Fenytestver/WIP/pcb/SPCombined/schematics.brd

## EAGLE design pcb/SPCombined/schematics.brd (2019-07-12)

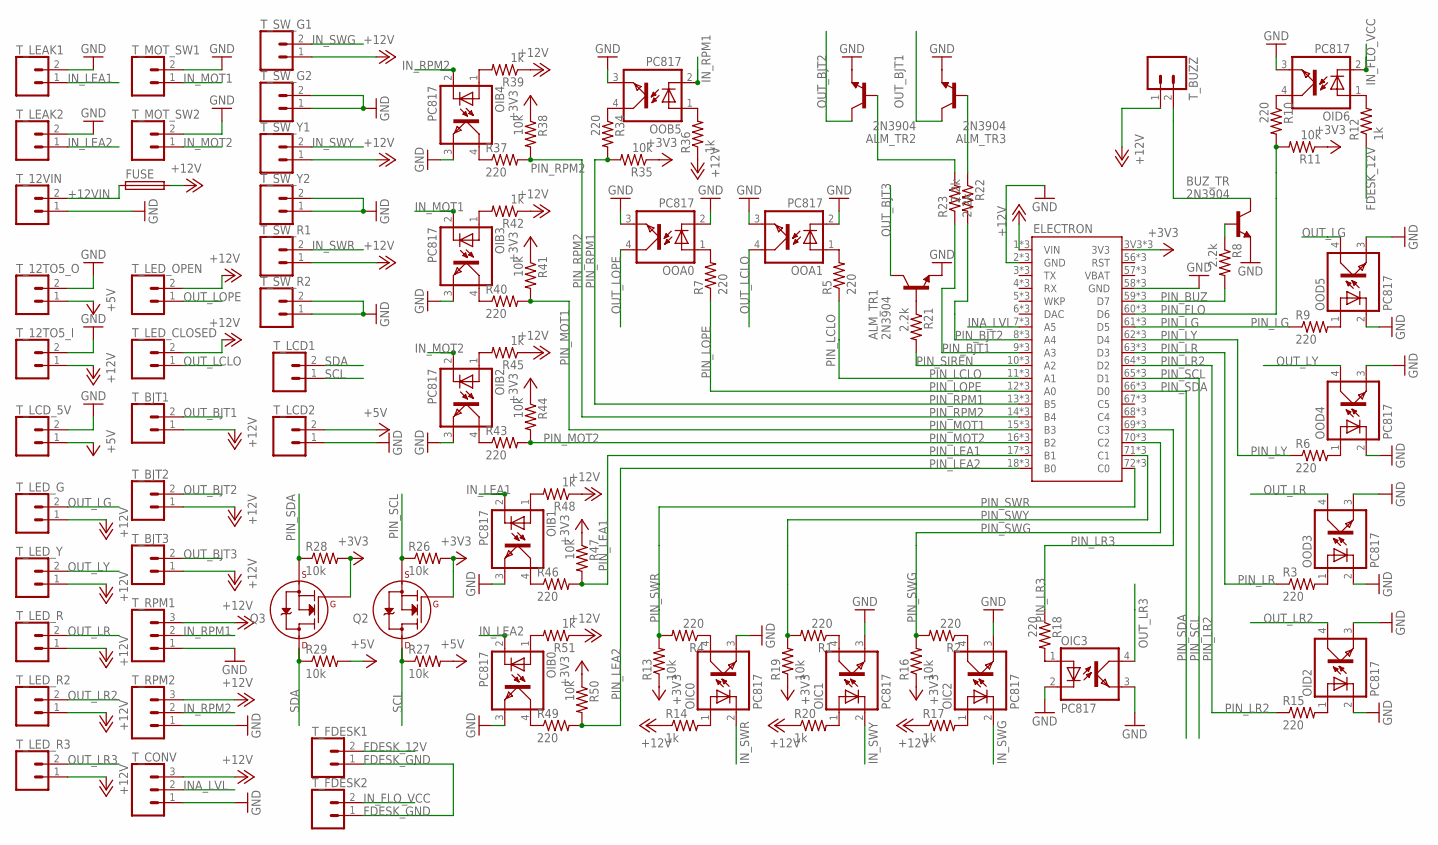
[picture p1: schematic schematics.sch]

Parts:
ALM_TR1, ALM_TR2, ALM_TR3: 2N3904; TO92
BUZ_TR: 2N3904; TO92
ELECTRON: ELECTRONDUALROW; ELECTRON_DUAL-ROW
FUSE: SH25
OIB0, OIB1, OIB2, OIB3, OIB4: PC817; DIL04
OIC0, OIC1, OIC2, OIC3: PC817; DIL04
OID2, OID6: PC817; DIL04
OOA0, OOA1: PC817; DIL04
OOB5: PC817; DIL04
OOD3, OOD4, OOD5: PC817; DIL04
Q2, Q3: 2N7000_TO92; TO-92
R1, R2, R3, R4, R5, R6, R7, R9, R10, R15, R18, R34, R37, R40, R43, R46, R49: 220; 0207/7
R8, R21, R22, R23: 2.2k; 0207/7
R11, R13, R16, R19, R26, R27, R28, R29, R35, R38, R41, R44, R47, R50: 10k; 0207/7
R12, R14, R17, R20, R36, R39, R42, R45, R48, R51: 1k; 0207/7
T_12TO5_I, T_12TO5_O, T_12VIN: CONN_025MM; SCREWTERMINAL-5MM-2
T_BJT1, T_BJT2, T_BJT3: CONN_025MM; SCREWTERMINAL-5MM-2
T_BUZZ: CONN_025MM; SCREWTERMINAL-5MM-2
T_CONV: CONN_03-SCREW-5MM; SCREWTERMINAL-5MM-3
T_FDESK1, T_FDESK2: CONN_025MM; SCREWTERMINAL-5MM-2
T_LCD1, T_LCD2: CONN_025MM; SCREWTERMINAL-5MM-2
T_LCD_5V: CONN_025MM; SCREWTERMINAL-5MM-2
T_LEAK1, T_LEAK2: CONN_025MM; SCREWTERMINAL-5MM-2
T_LED_CLOSED: CONN_025MM; SCREWTERMINAL-5MM-2
T_LED_G: CONN_025MM; SCREWTERMINAL-5MM-2
T_LED_OPEN: CONN_025MM; SCREWTERMINAL-5MM-2
T_LED_R, T_LED_R2, T_LED_R3: CONN_025MM; SCREWTERMINAL-5MM-2
T_LED_Y: CONN_025MM; SCREWTERMINAL-5MM-2
T_MOT_SW1, T_MOT_SW2: CONN_025MM; SCREWTERMINAL-5MM-2
T_RPM1, T_RPM2: CONN_03-SCREW-5MM; SCREWTERMINAL-5MM-3
T_SW_G1, T_SW_G2: CONN_025MM; SCREWTERMINAL-5MM-2
T_SW_R1, T_SW_R2: CONN_025MM; SCREWTERMINAL-5MM-2
T_SW_Y1, T_SW_Y2: CONN_025MM; SCREWTERMINAL-5MM-2

Connections:
+3V3: ELECTRON.3V3, ELECTRON.55 (3V3), ELECTRON.91 (3V3), Q2.2 (G), Q3.2 (G), R11.1, R13.1, R16.1, R19.1, R26.2, R28.2, R35.1, R38.1, R41.1, R44.1, R47.1, R50.1
+5V: R27.2, R29.2, T_12TO5_O.1, T_LCD2.2, T_LCD_5V.1
+12V: ELECTRON.1 (VIN), ELECTRON.37 (VIN), ELECTRON.VIN, FUSE.2, R14.1, R17.1, R20.1, R36.1, R39.1, R42.1, R45.1, R48.1, R51.1, T_12TO5_I.1, T_BJT1.1, T_BJT2.1, T_BJT3.1, T_BUZZ.1, T_CONV.3, T_LED_CLOSED.2, T_LED_G.1, T_LED_OPEN.2, T_LED_R.1, T_LED_R2.1, T_LED_R3.1, T_LED_Y.1, T_RPM1.3, T_RPM2.3, T_SW_G1.1, T_SW_R1.1, T_SW_Y1.1
+12VIN: FUSE.1, T_12VIN.2
FDESK_12V: R12.1, T_FDESK1.2
FDESK_GND: T_FDESK1.1, T_FDESK2.1
GND: ALM_TR1.3 (E), ALM_TR2.3 (E), ALM_TR3.3 (E), BUZ_TR.3 (E), ELECTRON.2 (GND), ELECTRON.38 (GND), ELECTRON.58 (GND), ELECTRON.94 (GND), ELECTRON.GND, ELECTRON.GND@2 (GND), OIB0.3 (EMIT), OIB1.3 (EMIT), OIB2.3 (EMIT), OIB3.3 (EMIT), OIB4.3 (EMIT), OIC0.3 (EMIT), OIC1.3 (EMIT), OIC2.3 (EMIT), OIC3.2 (C), OIC3.3 (EMIT), OID2.2 (C), OID2.3 (EMIT), OID6.3 (EMIT), OOA0.2 (C), OOA0.3 (EMIT), OOA1.2 (C), OOA1.3 (EMIT), OOB5.3 (EMIT), OOD3.2 (C), OOD3.3 (EMIT), OOD4.2 (C), OOD4.3 (EMIT), OOD5.2 (C), OOD5.3 (EMIT), T_12TO5_I.2, T_12TO5_O.2, T_12VIN.1, T_CONV.1, T_LCD2.1, T_LCD_5V.2, T_LEAK1.2, T_LEAK2.2, T_MOT_SW1.2, T_MOT_SW2.2, T_RPM1.1, T_RPM2.1, T_SW_G2.1, T_SW_G2.2, T_SW_R2.1, T_SW_R2.2, T_SW_Y2.1, T_SW_Y2.2
INA_LVL: ELECTRON.7 (A5), ELECTRON.43 (A5), ELECTRON.A5, T_CONV.2
IN_FLO_VCC: OID6.2 (C), T_FDESK2.2
IN_LEA1: OIB1.2 (C), T_LEAK1.1
IN_LEA2: OIB0.2 (C), T_LEAK2.1
IN_MOT1: OIB3.2 (C), T_MOT_SW1.1
IN_MOT2: OIB2.2 (C), T_MOT_SW2.1
IN_RPM1: OOB5.2 (C), T_RPM1.2
IN_RPM2: OIB4.2 (C), T_RPM2.2
IN_SWG: OIC2.2 (C), T_SW_G1.2
IN_SWR: OIC0.2 (C), T_SW_R1.2
IN_SWY: OIC1.2 (C), T_SW_Y1.2
unnamed: OOD3.1 (A), R3.2
unnamed: OIC1.1 (A), R20.2
unnamed: OOD4.1 (A), R6.2
unnamed: OIC2.1 (A), R17.2
unnamed: OOD5.1 (A), R9.2
unnamed: BUZ_TR.2 (B), R8.1
unnamed: BUZ_TR.1 (C), T_BUZZ.2
unnamed: OID2.1 (A), R15.2
unnamed: OIC0.1 (A), R14.2
unnamed: OID6.1 (A), R12.2
unnamed: OOA1.1 (A), R5.2
unnamed: OID6.4 (COL), R10.1
unnamed: OIC0.4 (COL), R4.1
unnamed: OIC3.1 (A), R18.2
unnamed: OOA0.1 (A), R7.2
unnamed: OIC2.4 (COL), R2.1
unnamed: OIC1.4 (COL), R1.1
unnamed: ALM_TR1.2 (B), R21.1
unnamed: ALM_TR3.2 (B), R22.1
unnamed: ALM_TR2.2 (B), R23.2
unnamed: OOB5.1 (A), R36.2
unnamed: OOB5.4 (COL), R34.1
unnamed: OIB4.1 (A), R39.2
unnamed: OIB4.4 (COL), R37.1
unnamed: OIB3.1 (A), R42.2
unnamed: OIB3.4 (COL), R40.1
unnamed: OIB2.1 (A), R45.2
unnamed: OIB2.4 (COL), R43.1
unnamed: OIB1.1 (A), R48.2
unnamed: OIB1.4 (COL), R46.1
unnamed: OIB0.1 (A), R51.2
unnamed: OIB0.4 (COL), R49.1
OUT_BJT1: ALM_TR3.1 (C), T_BJT1.2
OUT_BJT2: ALM_TR2.1 (C), T_BJT2.2
OUT_BJT3: ALM_TR1.1 (C), T_BJT3.2
OUT_LCLO: OOA1.4 (COL), T_LED_CLOSED.1
OUT_LG: OOD5.4 (COL), T_LED_G.2
OUT_LOPE: OOA0.4 (COL), T_LED_OPEN.1
OUT_LR: OOD3.4 (COL), T_LED_R.2
OUT_LR2: OID2.4 (COL), T_LED_R2.2
OUT_LR3: OIC3.4 (COL), T_LED_R3.2
OUT_LY: OOD4.4 (COL), T_LED_Y.2
PIN_BJT1: ELECTRON.9 (A3), ELECTRON.45 (A3), ELECTRON.A3, R23.1
PIN_BJT2: ELECTRON.8 (A4), ELECTRON.44 (A4), ELECTRON.A4, R22.2
PIN_BUZ: ELECTRON.59 (D7), ELECTRON.95 (D7), ELECTRON.D7, R8.2
PIN_FLO: ELECTRON.60 (D6), ELECTRON.96 (D6), ELECTRON.D6, R10.2, R11.2
PIN_LCLO: ELECTRON.11 (A1), ELECTRON.47 (A1), ELECTRON.A1, R5.1
PIN_LEA1: ELECTRON.17 (B1), ELECTRON.53 (B1), ELECTRON.B1, R46.2, R47.2
PIN_LEA2: ELECTRON.18 (B0), ELECTRON.54 (B0), ELECTRON.B0, R49.2, R50.2
PIN_LG: ELECTRON.61 (D5), ELECTRON.97 (D5), ELECTRON.D5, R9.1
PIN_LOPE: ELECTRON.12 (A0), ELECTRON.48 (A0), ELECTRON.A0, R7.1
PIN_LR: ELECTRON.63 (D3), ELECTRON.99 (D3), ELECTRON.D3, R3.1
PIN_LR2: ELECTRON.64 (D2), ELECTRON.100 (D2), ELECTRON.D2, R15.1
PIN_LR3: ELECTRON.69 (C3), ELECTRON.105 (C3), ELECTRON.C3, R18.1
PIN_LY: ELECTRON.62 (D4), ELECTRON.98 (D4), ELECTRON.D4, R6.1
PIN_MOT1: ELECTRON.15 (B3), ELECTRON.51 (B3), ELECTRON.B3, R40.2, R41.2
PIN_MOT2: ELECTRON.16 (B2), ELECTRON.52 (B2), ELECTRON.B2, R43.2, R44.2
PIN_RPM1: ELECTRON.13 (B5), ELECTRON.49 (B5), ELECTRON.B5, R34.2, R35.2
PIN_RPM2: ELECTRON.14 (B4), ELECTRON.50 (B4), ELECTRON.B4, R37.2, R38.2
PIN_SCL: ELECTRON.65 (D1), ELECTRON.101 (D1), ELECTRON.D1, Q2.1 (S), R26.1
PIN_SDA: ELECTRON.66 (D0), ELECTRON.102 (D0), ELECTRON.D0, Q3.1 (S), R28.1
PIN_SIREN: ELECTRON.10 (A2), ELECTRON.46 (A2), ELECTRON.A2, R21.2
PIN_SWG: ELECTRON.70 (C2), ELECTRON.106 (C2), ELECTRON.C2, R2.2, R16.2
PIN_SWR: ELECTRON.72 (C0), ELECTRON.108 (C0), ELECTRON.C0, R4.2, R13.2
PIN_SWY: ELECTRON.71 (C1), ELECTRON.107 (C1), ELECTRON.C1, R1.2, R19.2
SCL: Q2.3 (D), R27.1, T_LCD1.1
SDA: Q3.3 (D), R29.1, T_LCD1.2

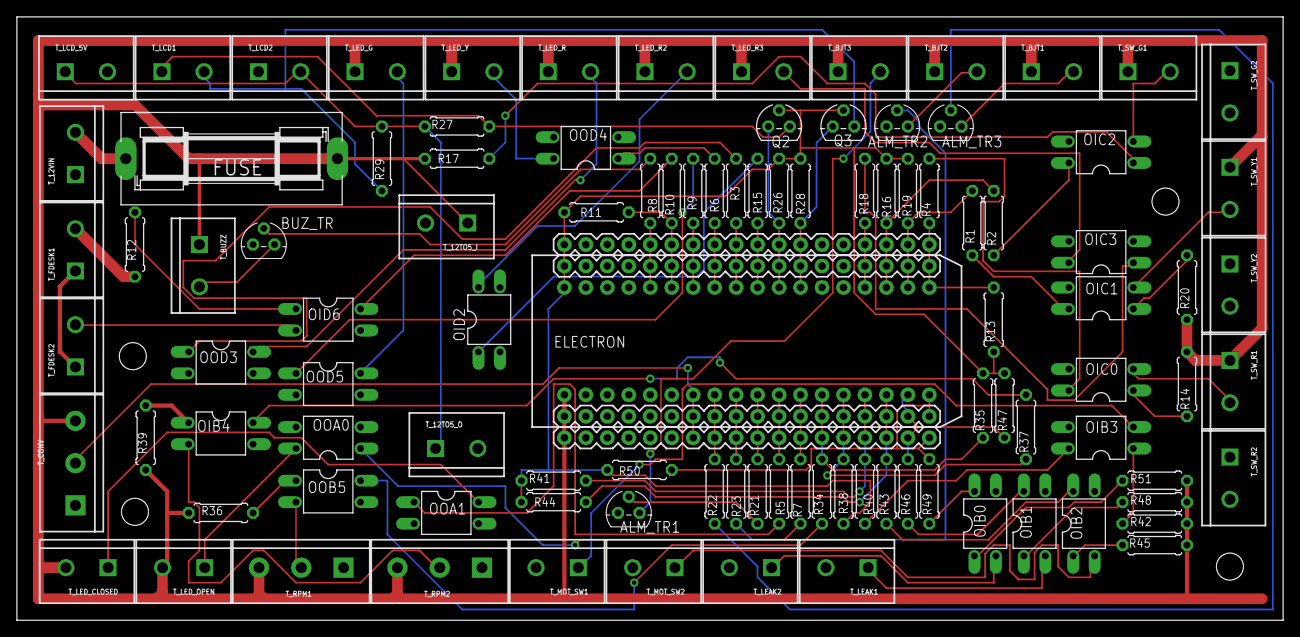
[picture p2: board schematics.brd from above]

Board: 2 copper layers, 149.8 x 71.4 mm, 102 parts (0 on the bottom side), 85 nets.
