Fenytestver/WIP/pcb/SumpPitNode/sumppitnodeboard.brd

## EAGLE design pcb/SumpPitNode/sumppitnodeboard.brd (2019-07-12)

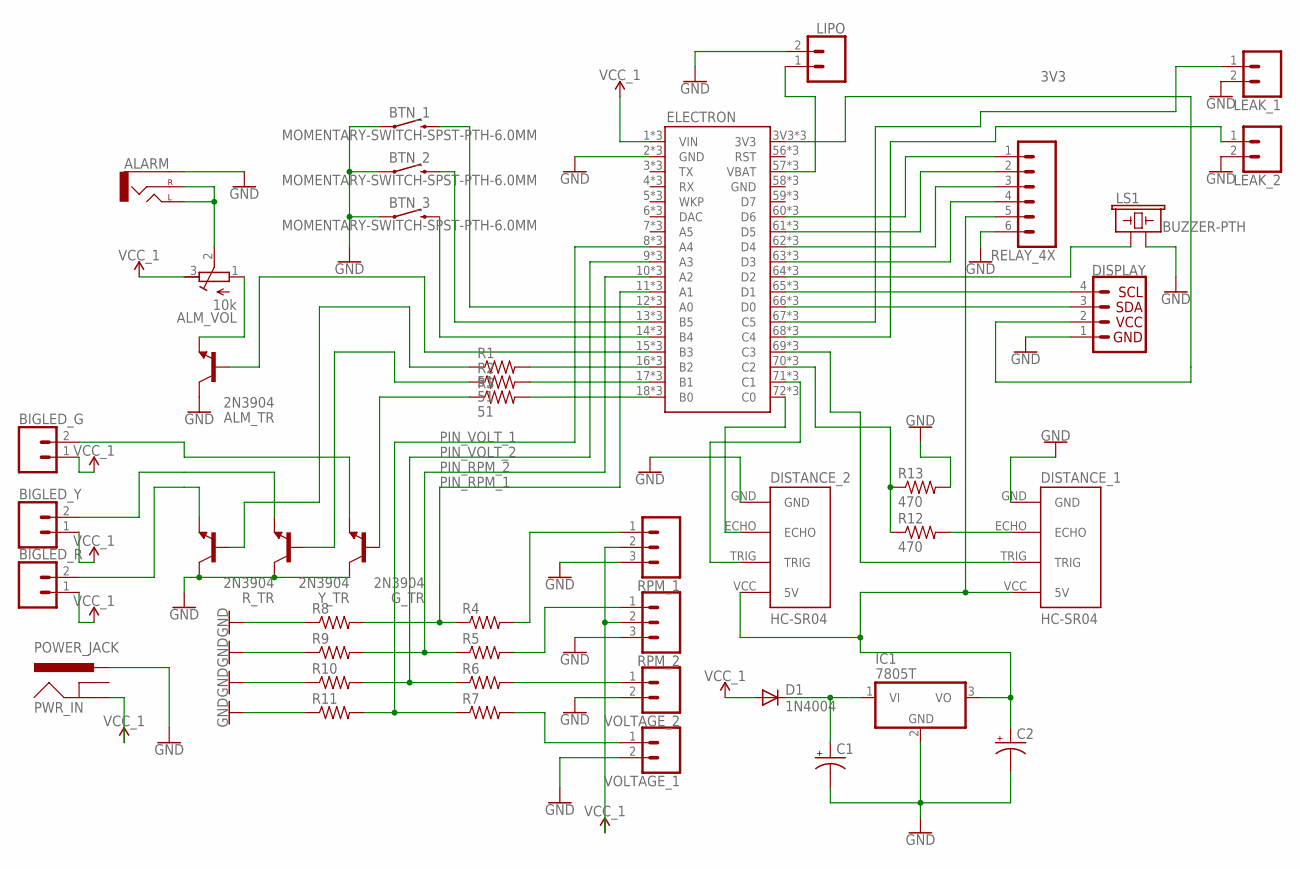
[picture p3: schematic sumppitnodeboard.sch]

Parts:
ALARM: AUDIO_JACK_2.5MM_2.5MM; STEREOJACK2.5MM_STEREOJACK2.5MM
ALM_TR: 2N3904; TO92
ALM_VOL: 10k; RTRIM64W
BIGLED_G: CONN_02; 1X02
BIGLED_R: CONN_02; 1X02
BIGLED_Y: CONN_02; 1X02
BTN_1, BTN_2, BTN_3: MOMENTARY-SWITCH-SPST-PTH-6.0MM; TACTILE_SWITCH_PTH_6.0MM
C1, C2: CPOL-USE1.8-4; E1,8-4
D1: 1N4004; DO41-10
DISPLAY: I2C_STANDARD; 1X04
DISTANCE_1, DISTANCE_2: HC-SR04; HC-SR04_FOOTPRINT
ELECTRON: ELECTRONDUALROW; ELECTRON_DUAL-ROW
G_TR: 2N3904; TO92
IC1: 7805T; TO220H
LEAK_1, LEAK_2: CONN_02; 1X02
LIPO: CONN_02JST-PTH-2; JST-2-PTH
LS1: BUZZER-PTH; BUZZER-12MM
PWR_IN: POWER_JACK; POWER_JACK_PTH
R1, R2, R3: 51; 0204/5
R4, R5, R6, R7, R8, R9, R10, R11: R-US_0204/5; 0204/5
R12, R13: 470; 0204/5
RELAY_4X: CONN_06LOCK; 1X06_LOCK
RPM_1, RPM_2: CONN_03; 1X03
R_TR: 2N3904; TO92
VOLTAGE_1, VOLTAGE_2: CONN_02; 1X02
Y_TR: 2N3904; TO92

Connections:
3V3: DISPLAY.2, ELECTRON.3V3, ELECTRON.55 (3V3), ELECTRON.91 (3V3)
GND: ALARM.RING1 (SLEEVE), ALM_TR.1 (C), BTN_1.1, BTN_2.1, BTN_3.1, C1.-, C2.-, DISPLAY.1, DISTANCE_1.GND, DISTANCE_2.GND, ELECTRON.2 (GND), ELECTRON.38 (GND), ELECTRON.58 (GND), ELECTRON.94 (GND), ELECTRON.GND, ELECTRON.GND@2 (GND), G_TR.1 (C), IC1.2 (GND), LEAK_1.2, LEAK_2.2, LIPO.2, LS1.- (2), PWR_IN.PWR, R8.1, R9.1, R10.1, R11.1, R13.2, RELAY_4X.6, RPM_1.3, RPM_2.3, R_TR.1 (C), VOLTAGE_1.2, VOLTAGE_2.2, Y_TR.1 (C)
unnamed: ALARM.SHIELD (LEFT), ALARM.TIP (RIGHT), ALM_VOL.2 (S)
unnamed: ALM_TR.3 (E), ALM_VOL.1 (A)
unnamed: ALM_TR.2 (B), ELECTRON.15 (B3), ELECTRON.51 (B3), ELECTRON.B3
unnamed: R1.1, R_TR.2 (B)
unnamed: ELECTRON.17 (B1), ELECTRON.53 (B1), ELECTRON.B1, R2.2
unnamed: ELECTRON.18 (B0), ELECTRON.54 (B0), ELECTRON.B0, R3.2
unnamed: BTN_3.3 (2), ELECTRON.14 (B4), ELECTRON.50 (B4), ELECTRON.B4
unnamed: ELECTRON.57 (VBAT), ELECTRON.93 (VBAT), ELECTRON.VBAT, LIPO.1
unnamed: BTN_2.3 (2), ELECTRON.13 (B5), ELECTRON.49 (B5), ELECTRON.B5
unnamed: BTN_1.3 (2), ELECTRON.12 (A0), ELECTRON.48 (A0), ELECTRON.A0
unnamed: DISPLAY.3, ELECTRON.66 (D0), ELECTRON.102 (D0), ELECTRON.D0
unnamed: DISPLAY.4, ELECTRON.65 (D1), ELECTRON.101 (D1), ELECTRON.D1
unnamed: BIGLED_G.2, G_TR.3 (E)
unnamed: DISTANCE_1.ECHO, R12.2
unnamed: DISTANCE_2.ECHO, ELECTRON.72 (C0), ELECTRON.108 (C0), ELECTRON.C0
unnamed: DISTANCE_2.TRIG, ELECTRON.71 (C1), ELECTRON.107 (C1), ELECTRON.C1
unnamed: DISTANCE_1.TRIG, ELECTRON.69 (C3), ELECTRON.105 (C3), ELECTRON.C3
unnamed: C1.+, D1.C, IC1.1 (VI)
unnamed: ELECTRON.16 (B2), ELECTRON.52 (B2), ELECTRON.B2, R1.2
unnamed: R2.1, Y_TR.2 (B)
unnamed: G_TR.2 (B), R3.1
unnamed: ELECTRON.64 (D2), ELECTRON.100 (D2), ELECTRON.D2, LS1.+ (1)
unnamed: ELECTRON.67 (C5), ELECTRON.103 (C5), ELECTRON.C5, LEAK_1.1
unnamed: R6.2, VOLTAGE_2.1
unnamed: R5.2, RPM_2.1
unnamed: R4.2, RPM_1.1
unnamed: R7.2, VOLTAGE_1.1
unnamed: ELECTRON.70 (C2), ELECTRON.106 (C2), ELECTRON.C2, R12.1, R13.1
unnamed: BIGLED_Y.2, Y_TR.3 (E)
unnamed: BIGLED_R.2, R_TR.3 (E)
unnamed: ELECTRON.68 (C4), ELECTRON.104 (C4), ELECTRON.C4, LEAK_2.1
unnamed: C2.+, DISTANCE_1.VCC (5V), DISTANCE_2.VCC (5V), IC1.3 (VO), RELAY_4X.5
unnamed: ELECTRON.63 (D3), ELECTRON.99 (D3), ELECTRON.D3, RELAY_4X.4
unnamed: ELECTRON.62 (D4), ELECTRON.98 (D4), ELECTRON.D4, RELAY_4X.3
unnamed: ELECTRON.61 (D5), ELECTRON.97 (D5), ELECTRON.D5, RELAY_4X.2
unnamed: ELECTRON.60 (D6), ELECTRON.96 (D6), ELECTRON.D6, RELAY_4X.1
PIN_RPM_1: ELECTRON.11 (A1), ELECTRON.47 (A1), ELECTRON.A1, R4.1, R8.2
PIN_RPM_2: ELECTRON.10 (A2), ELECTRON.46 (A2), ELECTRON.A2, R5.1, R9.2
PIN_VOLT_1: ELECTRON.8 (A4), ELECTRON.44 (A4), ELECTRON.A4, R7.1, R11.2
PIN_VOLT_2: ELECTRON.9 (A3), ELECTRON.45 (A3), ELECTRON.A3, R6.1, R10.2
VCC_1: ALM_VOL.3 (E), BIGLED_G.1, BIGLED_R.1, BIGLED_Y.1, D1.A, ELECTRON.1 (VIN), ELECTRON.37 (VIN), ELECTRON.VIN, PWR_IN.GND, RPM_1.2, RPM_2.2

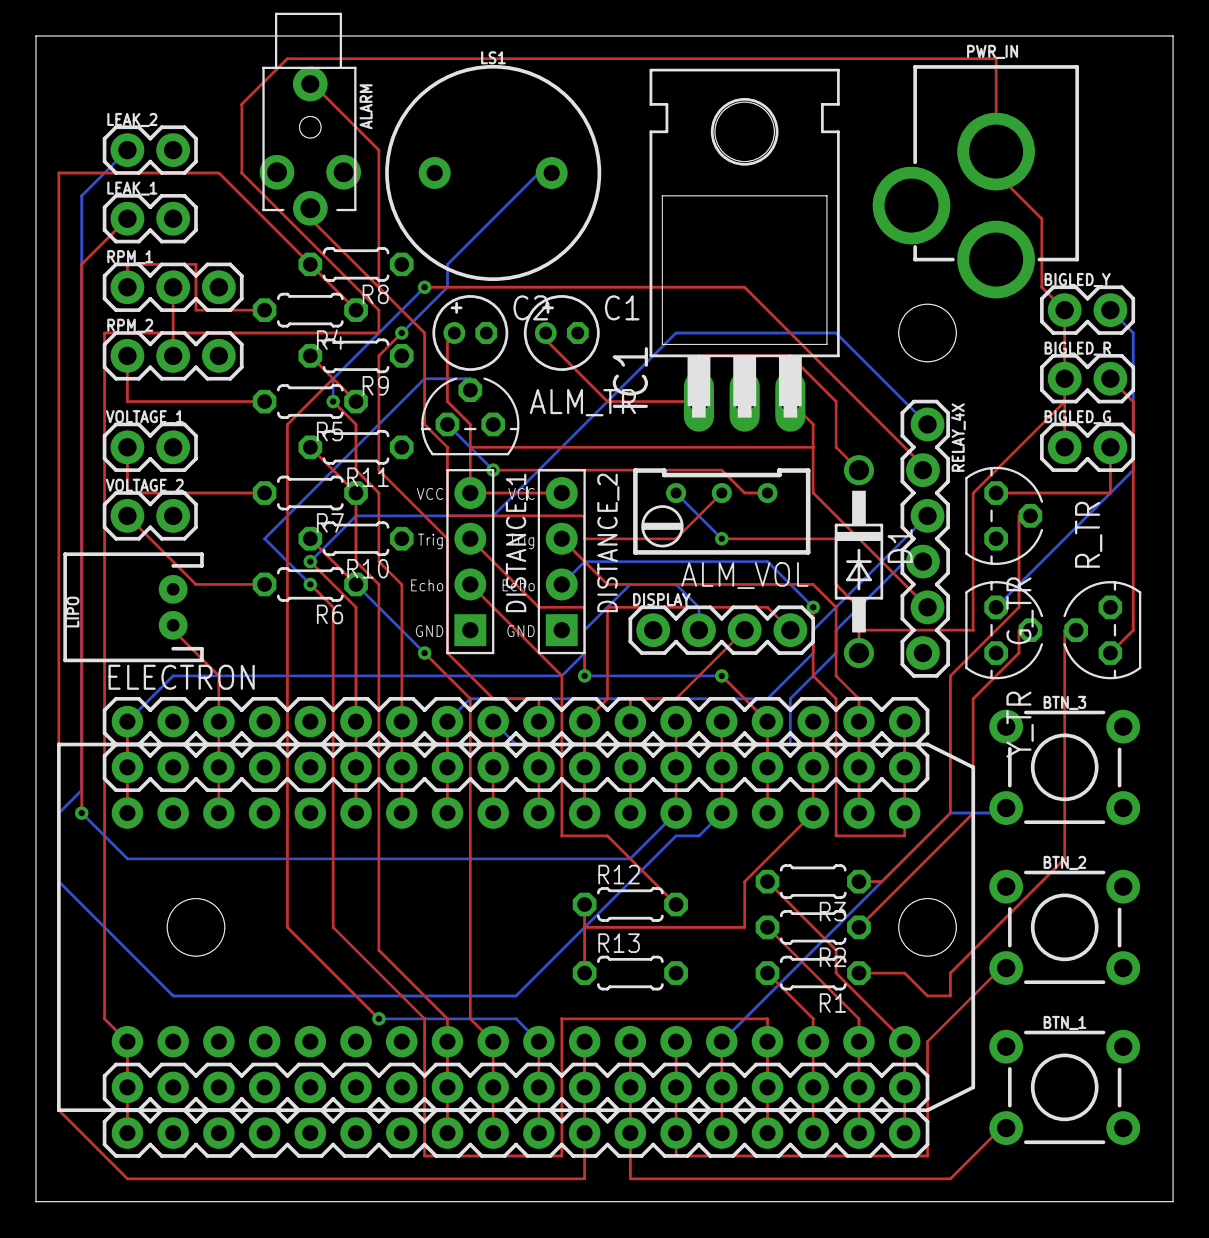
[picture p4: board sumppitnodeboard.brd from above]

Board: 2 copper layers, 63.2 x 64.8 mm, 43 parts (0 on the bottom side), 43 nets.
