Fenytestver/WIP/sumppitmodel/src/spn_config.h

#ifdef DEBUG
//#include <iostream>
#endif // DEBUG

#ifndef SPNCONFIG_H
#define SPNCONFIG_H

// Number of pumps
#define SPN_PUMP_COUNT 2
// give a little time after a turn on to spin up the pump
#define SPN_PUMP_SPINUP_TIME 2000L
#define SPN_PUMP_CYCLE_LENGTH_NORMAL 10000L
// Pump uptime that triggers technical alert. No alert below this.
#define SPN_PUMP_CYCLE_MAX_LENGTH_TECHNICAL 30000L
// Pump uptime that triggers critical alert. Technical alert below this.
#define SPN_PUMP_CYCLE_MAX_LENGTH_CRITICAL 40000L
// The usual RPM of the pump motor
#define SPN_PUMP_STD_RPM 400
// Technical alert above this. Deviation to STD_RPM (unit:RPM +/-).
// Normal below this.
#define SPN_PUMP_RPM_DEVI_TECHNICAL 40
// The instability quotient for rpm. The margin between turning on/off.
#define SPN_PUMP_RPM_DEVI_VARIANCE 5
// Technical alert above this. Deviation to STD_RPM (unit:RPM +/-).
// Technical alert below this.
#define SPN_PUMP_RPM_DEVI_CRITICAL 70
// Voltage threshold
#define SPN_PUMP_LOW_VOLTAGE_THRESHOLD 10.0

// Water levels
// Pump turns off when reached
#define SPN_WATER_LOW 10
// Pump should turn on at this level
#define SPN_WATER_HIGH 30
// Critical water level.
#define SPN_WATER_CRITICAL 80
#define SPN_WATER_VARIANCE 5
#define SPN_WATER_LEVEL_TOLERANCE_PERCENT 5
// Magic, do not touch.
// Alert levels
#define SPN_ALERT_NO_ALERT 0
#define SPN_ALERT_TECHNICAL 1
#define SPN_ALERT_CRITICAL 2

// Node related
#define SPN_ALARM_NO_ALARM (0)
#define SPN_ALARM_LEAK (1<<0)
#define SPN_ALARM_PUMP_RPM_TECHNICAL (1<<1)
#define SPN_ALARM_PUMP_RPM_CRITICAL (1<<2)
#define SPN_ALARM_PUMP_VOLTAGE_CRITICAL (1<<3)
#define SPN_ALARM_PUMP_CYCLE_TECHNICAL (1<<4)
#define SPN_ALARM_PUMP_CYCLE_CRITICAL (1<<5)
#define SPN_ALARM_WATER_CRITICAL (1<<6)
#define SPN_ALARM_WATER_LOW (1<<7)
#define SPN_ALARM_SYSTEM_ERROR (1<<8)
#define SPN_ALARM_FLOAT_SWITCH_CRITICAL (1<<9)
#define SPN_ALARM_PUMP_OVERWHELMED_TECHNICAL (1<<10)
#define SPN_ALARM_PUMP_OVERWHELMED_CRITICAL (1<<11)
#define SPN_ALARM_PUMP_FAILED_TECHNICAL (1<<12)
#define SPN_ALARM_PUMP_FAILED_CRITICAL (1<<13)
#define SPN_STATUS_BITS (14)
// all technical alerts
#define SPN_ALERT_ALL_TECHNICAL \
  (SPN_ALARM_PUMP_RPM_TECHNICAL \
   | SPN_ALARM_PUMP_CYCLE_TECHNICAL \
   | SPN_ALARM_WATER_LOW \
   | SPN_ALARM_PUMP_OVERWHELMED_TECHNICAL \
   | SPN_ALARM_PUMP_FAILED_TECHNICAL \
   | SPN_ALARM_LEAK \
   | SPN_ALARM_SYSTEM_ERROR)

// all critical alerts
#define SPN_ALERT_ALL_CRITICAL \
  (SPN_ALARM_PUMP_RPM_CRITICAL \
   | SPN_ALARM_PUMP_VOLTAGE_CRITICAL \
   | SPN_ALARM_PUMP_CYCLE_CRITICAL \
   | SPN_ALARM_WATER_CRITICAL \
   | SPN_ALARM_FLOAT_SWITCH_CRITICAL \
   | SPN_ALARM_PUMP_OVERWHELMED_CRITICAL \
   | SPN_ALARM_PUMP_FAILED_CRITICAL)

   #define SPN_ALERT_ALL_CRITICAL_SHUTOFF \
     (SPN_ALARM_WATER_CRITICAL \
      | SPN_ALARM_PUMP_OVERWHELMED_CRITICAL \
	  | SPN_ALARM_FLOAT_SWITCH_CRITICAL)


namespace spn {
  int abso(int a);
  void sb(int& flag, int mask, bool condition);
  bool isTechnical(int reason);
  bool isCritical(int reason);
  bool isCriticalShutoff(int reason);
  double mapp(double x, double in_min, double in_max, double out_min, double out_max);
  long mapp(long x, long in_min, long in_max, long out_min, long out_max);
  void statusToString(int status, char* out);
  long millisToSec(long millis);
  int toPercent(int value, int complete);
  int toPercentExtra(int value, int complete);
}

// The main system modes
enum Mode {
  SPN_INITIALIZING, SPN_DISARMED, SPN_ARMED, SPN_MAINTENANCE, SPN_SYS_ERROR
}; // end SumpPitNodeModes

#endif // SPNCONFIG_H
