Fenytestver/WIP/sumppitmodel/src/sumppitsensor.cpp

#include "sumppitsensor.h"

SumpPitSensor::SumpPitSensor(WaterLevelSensor* _waterLevelSensors, int _numWaterSensors,
                  LeakSensor* _leakSensors, int _numLeakSensors,
                  MultiPump* _pump)
{
  //ctor
  waterLevelSensors = _waterLevelSensors;
  leakSensors = _leakSensors;
  numWaterSensors = _numWaterSensors;
  pump = _pump;
  lastWaterLevel = 0;
}

SumpPitSensor::~SumpPitSensor()
{
  //dtor
}

void SumpPitSensor::setup() {
  pump->setup();
}

bool SumpPitSensor::isLeaking()
{
  return leakSensors->isLeaking();
}
int SumpPitSensor::checkState(State* outstate)
{
  int state = SPN_ALARM_NO_ALARM;
  int leakState = checkLeakState();
  state |= checkPumpState();
  state |= checkWaterLevelState(outstate);
  state |= leakState;
  outstate->leak = (leakState != SPN_ALARM_NO_ALARM);

  if ((state & SPN_ALARM_WATER_LOW) != 0
      && (!outstate->pump1On && !outstate->pump2On)) {
    // remove flag if pumps are not running
    state = state & ~(SPN_ALARM_WATER_LOW);
  }

  int waterLevel = waterLevelSensors->measureLevel();
  if (lastWaterLevel == 0 && (pump->isTurnedOn(0) || pump->isTurnedOn(1))) {
    lastWaterLevel = waterLevel;
  } else if (lastWaterLevel != 0 && (!pump->isTurnedOn(0) && !pump->isTurnedOn(1))) {
    lastWaterLevel = 0;
  }

  if (lastWaterLevel != 0
      && waterLevel > lastWaterLevel + SPN_WATER_LEVEL_TOLERANCE_PERCENT) {
    if ((pump->isTurnedOn(0) && pump->getPumpUptime(0) > SPN_PUMP_SPINUP_TIME)
         && (pump->isTurnedOn(1) && pump->getPumpUptime(1) > SPN_PUMP_SPINUP_TIME)) {
      state |= SPN_ALARM_PUMP_OVERWHELMED_CRITICAL;
    } else if ((pump->isTurnedOn(0) && pump->getPumpUptime(0) > SPN_PUMP_SPINUP_TIME)
         || (pump->isTurnedOn(1) && pump->getPumpUptime(1) > SPN_PUMP_SPINUP_TIME)) {
      state |= SPN_ALARM_PUMP_OVERWHELMED_TECHNICAL;
    }
  }

  int lastExpectedPumpState = expectedPumpState;
  if ((lastExpectedPumpState < SPN_MULTIPUMP_TURBO && waterLevel >= SPN_WATER_CRITICAL + SPN_WATER_VARIANCE)
    || (lastExpectedPumpState == SPN_MULTIPUMP_TURBO && waterLevel >= SPN_WATER_CRITICAL)) {
    expectedPumpState = SPN_MULTIPUMP_TURBO;
  } else if (((lastExpectedPumpState < SPN_MULTIPUMP_ON) && waterLevel >= (waterLevelSensors->getWaterPercentHigh() + SPN_WATER_VARIANCE))
    || ((lastExpectedPumpState >= SPN_MULTIPUMP_ON) && waterLevel >= waterLevelSensors->getWaterPercentHigh())) {
    expectedPumpState = SPN_MULTIPUMP_ON;
  } else if (waterLevel < waterLevelSensors->getWaterPercentHigh()) {
    expectedPumpState = SPN_MULTIPUMP_OFF;
  }

  switch (expectedPumpState) {
    case SPN_MULTIPUMP_ON:
      if (!pump->isTurnedOn(0) && !pump->isTurnedOn(1)) {
        state |= SPN_ALARM_PUMP_FAILED_TECHNICAL;
      }
      break;
    case SPN_MULTIPUMP_TURBO:
      if (!pump->isTurnedOn(0) || !pump->isTurnedOn(1)) {
        state |= SPN_ALARM_PUMP_FAILED_TECHNICAL;
      }
      break;
  }

  return state;
}

int SumpPitSensor::checkPumpState()
{
  return pump->checkState();
}

int SumpPitSensor::checkWaterLevelState(State* outstate)
{
  int state = waterLevelSensors->checkState(outstate);
  // TODO: rename waterlevelsensors to single
  return state;
}

int SumpPitSensor::checkLeakState()
{
  return isLeaking() ? SPN_ALARM_LEAK : SPN_ALARM_NO_ALARM;
}

void SumpPitSensor::updatePump(State* state)
{
  pump->update(state);
}
