Fenytestver/WIP/SumpPitSensorProject/src/application.ino

// If you get File not found error for 'localsettings.h', please
// copy the localsettings.h file from SumpPitSensorProject to
// SumpPitSensorProject/src
#include "localsettings.h"

#define PLATFORM_PHOTON 1
#define PLATFORM_ELECTRON 2

// enable cloud by default.
// enter this to disable
// #define CLOUD_ENABLED false
#ifndef CLOUD_ENABLED
#define CLOUD_ENABLED true
#endif

#ifndef SIM_3RD_PARTY
#define SIM_3RD_PARTY false
#endif

#ifndef PLATFORM
#error "Platform is not defined, please open application.ino"
#endif

#define DEBUG 0
#include "impl.ino"
#include "sumppitinputs.h"
#include "sumppitnode.h"
#include "application.h"

// Main system mode. Do not change this!
SYSTEM_MODE(MANUAL);
SYSTEM_THREAD(ENABLED);

// Photon platform from here
#if PLATFORM == PLATFORM_PHOTON

// Electron platform from here
#elif PLATFORM == PLATFORM_ELECTRON

#endif
/////////////////////////
// fallback to no pin when something is not defined.
/////////////////////////
#ifndef PIN_LED_GREEN
#define PIN_LED_GREEN PIN_NO_PIN
#endif
#ifndef PIN_LED_YELLOW
#define PIN_LED_YELLOW PIN_NO_PIN
#endif
#ifndef PIN_LED_RED
#define PIN_LED_RED PIN_NO_PIN
#endif
#ifndef PIN_LEAK_1
#define PIN_LEAK_1 PIN_NO_PIN
#endif
#ifndef PIN_LEAK_2
#define PIN_LEAK_2 PIN_NO_PIN
#endif
#ifndef PIN_LEAK_3
#define PIN_LEAK_3 PIN_NO_PIN
#endif
#ifndef PIN_BUTTON_1
#define PIN_BUTTON_1 PIN_NO_PIN
#endif
#ifndef PIN_BUTTON_2
#define PIN_BUTTON_2 PIN_NO_PIN
#endif
#ifndef PIN_BUTTON_3
#define PIN_BUTTON_3 PIN_NO_PIN
#endif
#ifndef PIN_BUZZER
#define PIN_BUZZER PIN_NO_PIN
#endif
#ifndef PIN_SIREN
#define PIN_SIREN PIN_NO_PIN
#endif
#ifndef PIN_WATERLEVEL
#define PIN_WATERLEVEL PIN_NO_PIN
#endif
#ifndef PIN_PUMP_VOLTAGE_1
#define PIN_PUMP_VOLTAGE_1 PIN_NO_PIN
#endif
#ifndef PIN_PUMP_VOLTAGE_2
#define PIN_PUMP_VOLTAGE_2 PIN_NO_PIN
#endif
#ifndef PIN_PUMP_RPM_1
#define PIN_PUMP_RPM_1 PIN_NO_PIN
#endif
#ifndef PIN_PUMP_RPM_2
#define PIN_PUMP_RPM_2 PIN_NO_PIN
#endif

#ifndef PIN_FLOAT_SWITCH_1
#define PIN_FLOAT_SWITCH_1 PIN_NO_PIN
#endif

#ifndef PIN_FLOAT_SWITCH_2
#define PIN_FLOAT_SWITCH_2 PIN_NO_PIN
#endif

#ifndef SYNC_ENABLED
#define SYNC_ENABLED false
#endif
#ifndef SYNC_PERIOD_MIN
#define SYNC_PERIOD_MIN 30000L
#endif
#ifndef SYNC_PERIOD_MAX
#define SYNC_PERIOD_MAX 600000L
#endif
#ifndef SYNC_PERIOD_MAX_TECHNICAL
#define SYNC_PERIOD_MAX_TECHNICAL SYNC_PERIOD_MAX
#endif
#ifndef SYNC_PERIOD_MAX_CRITICAL
#define SYNC_PERIOD_MAX_CRITICAL SYNC_PERIOD_MAX
#endif
#ifndef SPN_BUTTON_LONG_PRESS_TIME
#define SPN_BUTTON_LONG_PRESS_TIME 30000
#endif
#ifndef DISPLAY_I2C_ADDR
#define DISPLAY_I2C_ADDR 0x27
#endif


// end of fallback definitions.

//////////////////////////
// minimum measurable water disatance (inches)
#define WATER_DIST_MIN 0
#define WATER_DIST_MAX 3516
#define WATER_DIST_LOW 300
#define WATER_DIST_HIGH 1000

#define DISPLAY_COLS 20
#define DISPLAY_ROWS 4

#define EEPROM_DEVICE_ID (sizeof(int) * 1)
#define EEPROM_VALID (sizeof(int) * 2)
#define EEPROM_WATER_LOW_VALUE (sizeof(int) * 3)
#define EEPROM_WATER_HIGH_VALUE (sizeof(int) * 4)
#define EEPROM_WATER_LOW_IN (sizeof(int) * 5)
#define EEPROM_WATER_HIGH_IN (sizeof(int) * 6)
#define EEPROM_WATER_HIGH_PERCENT (sizeof(int) * 7)
#define EEPROM_WATER_LOW_HIGH_DIST (sizeof(int) * 9)
#define EEPROM_CLUSTER_ID (sizeof(int) * 11)
#define EEPROM_THE_ONLY_VALID_VALUE 115

int deviceId;
RealSiren* siren;
RealBuzzer* buzzer;
RealSystemTime* systemTime;
RealLeakSensor* leakSensor;
HardwarePinLed* ledGreen;
HardwarePinLed* ledYellow;
HardwarePinLed* ledRed;
RealButton* armButton;
RealButton* maintenanceButton;
RealButton* disarmButton;
RealShutoffValve* shutoffValve;
AnalogWaterLevelSensor* waterLevelSensor;
SumpPitInputs* inputs;
RealRpmSensor* rpmSensor1;
RealRpmSensor* rpmSensor2;
RealVoltageSensor* voltageSensor1;
RealVoltageSensor* voltageSensor2;
Pump* pump1;
Pump* pump2;
MultiPump* multiPump;
LcdDisplay* display;
LocalView* localView;
RealFloatSwitch* floatSwitch;
PMICVoltageSensor* systemVoltage;

PMIC power;

// TODO: 2 leak sensors
SumpPitSensor* sensor;
SumpPitNode* node;
FuelGauge fuel;

int waterLow;
int waterHigh;
int waterLowIn;
int waterHighIn;
int waterPercentHigh;
float waterLowHighDist;

int lastStatus = -1;
long lastStatusTime = 0L;
char statusString[SPN_STATUS_BITS + 1];
char publishString[256];
long syncPeriod = SYNC_PERIOD_MIN;
bool sendStatus = false;
// local staus variable copies
int lastMode;
int mode;
int rpm1;
int rpm2;
bool pump1On;
bool pump2On;
long alarmReason;
int pump1Uptime;
int pump2Uptime;
int levelIn;
int levelPercent;
bool leak;
bool shutoffValveState;
bool floatSwitchState;
bool lostVoltage = false;
int lastPumpsOn = 0;
int clusterId = 0;
SerialDebugOutput debugOutput(115200, ALL_LEVEL);

void saveEeprom() {
  EEPROM.put(EEPROM_WATER_LOW_VALUE, (int)waterLow);
  EEPROM.put(EEPROM_WATER_HIGH_VALUE, (int)waterHigh);
  EEPROM.put(EEPROM_WATER_LOW_IN, (int)waterLowIn);
  EEPROM.put(EEPROM_WATER_HIGH_IN, (int)waterHighIn);
  EEPROM.put(EEPROM_WATER_HIGH_PERCENT, (int)waterPercentHigh);
  EEPROM.put(EEPROM_WATER_LOW_HIGH_DIST, (float)waterLowHighDist);
  EEPROM.put(EEPROM_CLUSTER_ID, (int)clusterId);
}
bool publish(char* topic, char* value) {
  char topicWithCluster[128];
  sprintf(topicWithCluster, "c%d/%s", clusterId, topic);
  return Particle.publish(String(topicWithCluster), String(value), PRIVATE);
}

bool subscribe(char* topic, void (*handler)(const char*, const char*)) {
  char topicWithCluster[128];
  sprintf(topicWithCluster, "c%d/%s", clusterId, topic);
  INFO("Subscibe to %s", topicWithCluster);
  return Particle.subscribe(String(topicWithCluster), handler, MY_DEVICES);
}
// setup() runs once, when the device is first turned on.
void setup() {
  Serial.begin(115200);
  deviceId = -1;
  int validation;
  EEPROM.get(EEPROM_VALID, validation);
  if (validation != EEPROM_THE_ONLY_VALID_VALUE) {
    for (int i=EEPROM_VALID; i<32; ++i) {
      EEPROM.put(i, (int)-1);
    }
    EEPROM.put(EEPROM_VALID, (int)EEPROM_THE_ONLY_VALID_VALUE);
  }
  clusterId = getEepromInt(EEPROM_CLUSTER_ID, 0);
  deviceId = getEepromInt(EEPROM_DEVICE_ID, -1);
  waterLow = getEepromInt(EEPROM_WATER_LOW_VALUE, WATER_DIST_LOW);
  waterHigh = getEepromInt(EEPROM_WATER_HIGH_VALUE, WATER_DIST_HIGH);
  waterLowIn = getEepromInt(EEPROM_WATER_LOW_IN, 15);
  waterHighIn = getEepromInt(EEPROM_WATER_HIGH_IN, 75);
  waterPercentHigh = getEepromInt(EEPROM_WATER_HIGH_PERCENT, SPN_WATER_HIGH);
  waterLowHighDist = getEepromFloat(EEPROM_WATER_LOW_HIGH_DIST, (float)20.0);

  systemTime = new RealSystemTime();
  display = new LcdDisplay(DISPLAY_I2C_ADDR, DISPLAY_COLS, DISPLAY_ROWS);
  siren = new RealSiren(systemTime, PIN_SIREN);
  buzzer = new RealBuzzer(PIN_BUZZER);
  leakSensor = new RealLeakSensor(PIN_LEAK_1, PIN_LEAK_2, PIN_LEAK_3);
  ledGreen = new HardwarePinLed(PIN_LED_GREEN);
  ledYellow = new HardwarePinLed(PIN_LED_YELLOW);
  ledRed = new HardwarePinLed(PIN_LED_RED);
  armButton = new RealButton(systemTime, SPN_BUTTON_LONG_PRESS_TIME, PIN_BUTTON_1);
  maintenanceButton = new RealButton(systemTime, SPN_BUTTON_LONG_PRESS_TIME, PIN_BUTTON_2);
  disarmButton = new RealButton(systemTime, SPN_BUTTON_LONG_PRESS_TIME, PIN_BUTTON_3);
  shutoffValve = new RealShutoffValve(clusterId);
  waterLevelSensor = new AnalogWaterLevelSensor(
    PIN_WATERLEVEL, waterLow, waterHigh, waterLowIn, waterHighIn, waterPercentHigh);
  inputs = new SumpPitInputs(disarmButton, maintenanceButton, armButton);
  rpmSensor1 = new RealRpmSensor(PIN_PUMP_RPM_1, systemTime);
  rpmSensor2 = new RealRpmSensor(PIN_PUMP_RPM_2, systemTime);
  voltageSensor1 = new RealVoltageSensor(PIN_PUMP_VOLTAGE_1);
  voltageSensor2 = new RealVoltageSensor(PIN_PUMP_VOLTAGE_2);
  pump1 = new Pump(systemTime, rpmSensor1, voltageSensor1);
  pump2 = new Pump(systemTime, rpmSensor2, voltageSensor2);
  multiPump = new MultiPump();
  multiPump->addPump(pump1);
  multiPump->addPump(pump2);
  sensor = new SumpPitSensor(waterLevelSensor, 1, leakSensor, 1, multiPump);
  localView = new LocalView(display, systemTime, ledRed, ledGreen, ledYellow);
  floatSwitch = new RealFloatSwitch(PIN_FLOAT_SWITCH_1, PIN_FLOAT_SWITCH_2);
  systemVoltage = new PMICVoltageSensor(&power);
  node = new SumpPitNode(systemTime, siren, buzzer, localView, sensor, inputs, shutoffValve, floatSwitch, systemVoltage);
  node->setup();

  if (PIN_PUMP_RPM_1 != PIN_NO_PIN) {
    pinMode(PIN_PUMP_RPM_1, INPUT_PULLUP);
    attachInterrupt(PIN_PUMP_RPM_1, triggerRpm1, RISING);
  }
  if (PIN_PUMP_RPM_2 != PIN_NO_PIN) {
    pinMode(PIN_PUMP_RPM_2, INPUT_PULLUP);
    attachInterrupt(PIN_PUMP_RPM_2, triggerRpm2, RISING);
  }

  if (CLOUD_ENABLED) {
    connectToCloud();
    if (SIM_3RD_PARTY) {
      Particle.keepAlive(120);
    }
    bool success = Particle.function("arm", armSystem);
    success = Particle.function("disarm", disarmSystem);
    success = Particle.function("maintenance", startMaintenance);
    success = Particle.function("lcdInit", lcdInit);
    success = Particle.function("update", sendStatusNow);
    success = Particle.function("getLcd", sendScreen);
    success = Particle.function("setDeviceId", setDeviceId);
    success = Particle.function("setClusterId", setClusterId);
    success = Particle.function("getRawLevel", getRawLevel);
    success = Particle.function("setWaterLow", setWaterLow);
    success = Particle.function("setWaterHigh", setWaterHigh);
    success = Particle.function("setWaterLowIn", setWaterLowIn);
    success = Particle.function("setWaterHighIn", setWaterHighIn);
    success = Particle.function("setWaterLevels", setWaterLevels);
    success = Particle.function("reboot", reboot);
    success = Particle.function("calibrate", startCalib);
    success = Particle.function("clearCalib", clearCalibration);
    success = Particle.function("snooze", snooze);
    subscribe(PUB_SHUTOFF_STATE, shutoffValveHandler);
    subscribe("snoozeAlarm", snoozeHandler);
    subscribe("spnPing", pingStatusHandler);
    Particle.variable("waterLow", waterLow);
    Particle.variable("waterHigh", waterHigh);
    Particle.variable("waterLowIn", waterLowIn);
    Particle.variable("waterHighIn", waterHighIn);
    Particle.variable("waterHighP", waterPercentHigh);

    Particle.variable("deviceId", deviceId);
    Particle.variable("clusterId", clusterId);
    Particle.variable("mode", mode);
    Particle.variable("rpm1", rpm1);
    Particle.variable("rpm2", rpm2);
    Particle.variable("pump1On", pump1On);
    Particle.variable("pump2On", pump2On);
    Particle.variable("status", localView->statusString);

    Particle.variable("p1Uptime", pump1Uptime);
    Particle.variable("p2Uptime", pump2Uptime);
    Particle.variable("levelIn", levelIn);
    Particle.variable("levelP", levelPercent);
    Particle.variable("leak", leak);
    Particle.variable("shutoffValve", shutoffValveState);
    Particle.variable("floatSwitch", floatSwitchState);
  }
  INFO("Started");
  Serial.begin(115200);
}

void triggerRpm1() {
  ATOMIC_BLOCK() {
    rpmSensor1->trigger();
  }
}

void triggerRpm2() {
  ATOMIC_BLOCK() {
    rpmSensor2->trigger();
  }
}

int armSystem(String extra) {
  node->arm();
  return 0;
}
int disarmSystem(String extra) {
  node->disarm();
  return 0;
}
int startMaintenance(String extra) {
  node->maintenance();
  return 0;
}
int lcdInit(String extra) {
  display->setup();
  return 0;
}

int startCalib(String extra) {
  calibrate();
  return 0;
}

// loop() runs over and over again, as quickly as it can execute.
void loop() {
  if (CLOUD_ENABLED) {
    Particle.process();
  }

  State* state = node->update();
  mode = state->mode;
  rpm1 = state->pump1Rpm;
  rpm2 = state->pump2Rpm;
  pump1Uptime = state->pump1Uptime;
  pump2Uptime = state->pump2Uptime;
  levelIn = state->levelIn;
  levelPercent = state->levelPercent;
  leak = state->leak;
  shutoffValveState = state->shutoffValve;
  floatSwitchState = state->floatSwitch;
  pump1On = state->pump1On;
  pump2On = state->pump2On;
  int currPumpsOn = (pump1On ? 1 : 0) + (pump2On ? 1 : 0);
  if (lastPumpsOn != currPumpsOn) {
    INFO("Pums changed, send current state. pump1=%d, pump2=%d", pump1On, pump2On);
    sprintf(publishString, "{"
      "\"id\":\"%d\","
      "\"pumpsOn\":\"%d\","
      "\"pump1On\":\"%d\","
      "\"pump2On\":\"%d\""
      "}",
      deviceId,
      currPumpsOn,
      pump1On,
      pump2On);
    publish("pumpStatus", publishString);
    lastPumpsOn = currPumpsOn;
  }

  if (CLOUD_ENABLED && Particle.connected() == 1) {
    long now = systemTime->nowMillis();
    if (state->alarmReason != lastStatus) {
      sendStatus = true;
      // status changed
      syncPeriod = SYNC_PERIOD_MIN;
      lastStatusTime = now;
    }
    if (SYNC_ENABLED && now - lastStatusTime > syncPeriod) {
      sendStatus = true;
      syncPeriod = syncPeriod * 2;
      int maxSyncPeriod;
      if (isCritical(state->alarmReason)) {
        maxSyncPeriod = SYNC_PERIOD_MAX_CRITICAL;
      } else if (isTechnical(state->alarmReason)) {
        maxSyncPeriod = SYNC_PERIOD_MAX_TECHNICAL;
      } else {
        maxSyncPeriod = SYNC_PERIOD_MAX;
      }
      if (syncPeriod > maxSyncPeriod) {
        syncPeriod = maxSyncPeriod;
      }
      lastStatusTime = now;
    }
    if (lastMode != mode) {
      sendStatus = true;
    }
    if (sendStatus) {
      sendFullStatus(state);
      sendStatus = false;
    }
    lastMode = mode;
  }
  if (armButton->isPressed() && disarmButton->isPressed() && maintenanceButton->isPressed()) {
    while (armButton->isPressed() || disarmButton->isPressed() || maintenanceButton->isPressed()) {
      armButton->update();
      disarmButton->update();
      maintenanceButton->update();
      Particle.process();
    }
    calibrate();
  }

  if (systemVoltage->getVoltage() < 1.0) {
    lostVoltage = true;
  } else if (lostVoltage == true) {
    delay(500);
    lcdInit("");
    lostVoltage = false;
  }

  /*Serial.print("-----@");
  Serial.print(systemTime->nowMillis());
  Serial.println("-----");
  Serial.print("pump1Voltage:");
  Serial.println(voltageSensor1->getVoltage());
  Serial.print("pump2Voltage:");
  Serial.println(voltageSensor2->getVoltage());
  Serial.print("pump1Rpm:");
  Serial.println(pump1->getRpm());
  Serial.print("pump2Rpm:");
  Serial.println(pump2->getRpm());
  Serial.print("leakSensor:");
  Serial.println(leakSensor->isLeaking());
  delay(50);*/
}
int reboot(String extra) {
  saveEeprom();
  char * tmp = new char [extra.length()+1];
  std::strcpy (tmp, extra.c_str());
  display->displayMessage(tmp);
  System.reset();
  return 1;
}

int clearCalibration(String extra) {
  EEPROM.put(EEPROM_VALID, 0);
  reboot("");
}

double stringToDouble(String extra) {
  double result = -1;
  if (extra.length() > 0) {
    double tmp = extra.toFloat();
    if (tmp > 0) {
      result = tmp;
    }
  }
  return result;
}

int stringToInt(String extra) {
  int result = -1;
  if (extra.length() > 0) {
    int tmp = extra.toInt();
    if (tmp > 0) {
      result = tmp;
    }
  }
  return result;
}

int setDeviceId(String extra) {
  int extraInt = stringToInt(extra);
  if (extraInt > 0) {
    deviceId = extraInt;
    EEPROM.put(EEPROM_DEVICE_ID, deviceId);
  }
  return deviceId;
}

int setClusterId(String extra) {
  int extraInt = stringToInt(extra);
  if (extraInt > 0) {
    clusterId = extraInt;
    EEPROM.put(EEPROM_CLUSTER_ID, clusterId);
  }
  return clusterId;
}

int setWaterLow(String extra) {
  int extraInt = stringToInt(extra);
  if (extraInt > 0) {
    waterLow = extraInt;
  }
  return waterLow;
}

int setWaterHigh(String extra) {
  int extraInt = stringToInt(extra);
  if (extraInt > 0) {
    waterHigh = extraInt;
  }
  return waterHigh;
}

int setWaterHighIn(String extra) {
  int extraInt = stringToInt(extra);
  if (extraInt > 0) {
    waterHighIn = extraInt;
  }
  return waterHighIn;
}
int setWaterLowIn(String extra) {
  int extraInt = stringToInt(extra);
  if (extraInt > 0) {
    waterLowIn = extraInt;
  }
  return waterLowIn;
}
int setWaterLevels(String extra) {
  if (extra == nullptr) {
    return -1;
  }
  int comma = extra.indexOf(',');
  if (comma == -1) {
    return -2;
  }
  double first = stringToDouble(extra.substring(0, comma));
  double second = stringToDouble(extra.substring(comma + 1));

  if (first > 0 && second > 0) {
    int diffToSplit = SPN_WATER_CRITICAL - SPN_WATER_LOW;
    double center = (double)SPN_WATER_LOW +
      ((double)first)*((double)diffToSplit / (double)(first + second));
    waterLowHighDist = first;
    waterPercentHigh = (int)center;
    return waterPercentHigh;
  }
  return -3;
}
void connectToCloud() {
  if (CLOUD_ENABLED) {
    int attempt = 0;
    int len;
    if (Particle.connected() == false) {
      char message[20];
      attempt++;
      len = sprintf(message, "Connecting to Cloud.");
      message[len] = '\0';
      display->displayMessage(message);
      long start = systemTime->nowMillis();
      Particle.connect();
      long wait = 0;
    }
  }
}

int sendStatusNow(String extra) {
  sendStatus = true;
  return 0;
}

int sendScreen(String extra) {
  publish("lcdtext", display->getBank());
  return 0;
}

void pingStatusHandler(const char *event, const char *data) {
  sendStatus = true;
}

void shutoffValveHandler(const char *event, const char *data)
{
  INFO("shutoffValveHandler request: %s, %s", event, data);
  if (strcmp("true", data) == 0) {
    shutoffValve->activate();
  } else if (strcmp("false", data) == 0) {
    shutoffValve->deactivate();
  }
}

void snoozeHandler(const char *event, const char *data) {
  if (data != nullptr) {
    int snooze = stringToInt(data);
    if (snooze > 100) {
      node->snooze(snooze);
    }
  }
}

void sendFullStatus(State* state) {
  statusToString(state->alarmReason, statusString);
  INFO("Status=%d", statusString);
  int bars = 0;
  int rssi = 0;
  #if Wiring_WiFi == 1
      rssi = WiFi.RSSI();
  #elif Wiring_Cellular == 1
      CellularSignal sig = Cellular.RSSI();
      rssi = sig.rssi;
  #endif
  if (rssi < 0) {
      if (rssi >= -57) bars = 5;
      else if (rssi > -68) bars = 4;
      else if (rssi > -80) bars = 3;
      else if (rssi > -92) bars = 2;
      else if (rssi > -104) bars = 1;
  }

  sprintf(publishString,
    "{"
    "\"id\":\"%d\","
    "\"technical\":\"%d\","
    "\"critical\":\"%d\","
    "\"shutoffValve\":\"%s\","
    "\"alarm\":\"%s\", \"waterLevel\":\"%d\","
    "\"leakSensor\":\"%s\", \"mode\":\"%d\","
    "\"rpm1\":\"%d\",\"rpm2\":\"%d\","
    "\"uptime\":\"%d\",\"battery\":\"%.2f\","
    "\"rssi\":\"%d\",\"bars\":\"%d\","
    "\"floatSwitch\":\"%s\""
    "}",
    deviceId,
    isTechnical(node->state.alarmReason) ? 1 : 0,
    isCritical(node->state.alarmReason) ? 1 : 0,
    shutoffValve->isActive() ? "1" : "0",
    statusString, waterLevelSensor->measureLevel(),
    leakSensor->isLeaking() ? "1" : "0", node->state.mode,
    rpmSensor1->getRpm(), rpmSensor2->getRpm(),
    systemTime->nowMillis(), fuel.getVCell(),
    rssi, bars,
    floatSwitch->isTriggered() ? "1" : "0"
  );
  INFO("Publish Status=%d", publishString);
  publish("spnStatus", publishString);

  lastStatus = state->alarmReason;
}

int getEepromInt(int address, int def) {
  int tmp = -1;
  EEPROM.get(address, tmp);
  if (tmp > -1) {
    return tmp;
  }
  return def;
}

float getEepromFloat(int address, float def) {
  float tmp = -1;
  EEPROM.get(address, tmp);
  if (tmp > -1) {
    return tmp;
  }
  return def;
}

int getRawLevel(String extra) {
  return waterLevelSensor->readRaw();
}

int snooze(String extra) {
  int extraInt = stringToInt(extra);
  if (extraInt > 0) {
    return node->snooze(extraInt);
  }
  return node->snoozeRemaining();
}

class BoolOnPress : public OnButtonPressListener {
  public:
    BoolOnPress(bool& _b) {
      b = _b;
      b = false;
    }
    void onPress() {
      b=true;
    }
  private:
    bool b;
};

#define C_NONE -1
#define C_START 0
#define C_STAGE_1 1
#define C_STAGE_2 2
int calibState=C_NONE;
// bool armPressed = false;
// bool disarmPressed = false;
// BoolOnPress okOnPress(armPressed);
// BoolOnPress cancelOnPress(disarmPressed);

void calibrate() {
  bool finished = false;

  display->displayMessage(
    "Calibration\n"
    "Press arm to start.\nDisarm to cancel");
  Button* button = getPressedButton(armButton, disarmButton);
  if (button == disarmButton) {
    return;
  }
  // display->displayMessage(
  //   "Move sensor to bottom,\n"
  //   "then mount in place."
  //   "Press arm to save.\nDisarm to cancel");
  // button = getPressedButton(armButton, disarmButton);
  // if (button == disarmButton) {
  //   return;
  // }
  int highest = -1;
  char msg[22*4];
  while (!isPressed(armButton)) {
    int current = waterLevelSensor->readRaw();
    if (current > highest) {
      highest = current;
    }
    sprintf(msg, "Bottom: %d\nPress arm to save.", highest);
    display->displayMessage(msg);
    Particle.process();
  }
  int mountpoint = waterLevelSensor->readRaw();
  int offset = highest - mountpoint;
  int pumpOnAt;
  int pumpOffAt;
  finished = false;
  display->displayMessage("Waiting for pump\nto turn on.\n"
      "Disarm to cancel.");
  while (!finished) {
    pump1->update();
    pump2->update();
    if (isPressed(disarmButton)) {
      return;
    }
    if (multiPump->isTurnedOn(0) || multiPump->isTurnedOn(1)) {
      pumpOnAt = waterLevelSensor->readRaw();
      sprintf(msg, "Pump on at: %d\n"
          "Waiting for pump off\n"
          "Disarm to cancel.");
      display->displayMessage(msg);
      while (!finished
          && (multiPump->isTurnedOn(0) || multiPump->isTurnedOn(1))) {
            pump1->update();
            pump2->update();
        if (isPressed(disarmButton)) {
          return;
        }
        Particle.process();
      }
      if (!multiPump->isTurnedOn(0) && !multiPump->isTurnedOn(1)) {
        pumpOffAt = waterLevelSensor->readRaw();
        finished = true;
      } else {
        return;
      }
    }
    Particle.process();
  }
  double inchesLowHigh = waterLowHighDist;
  double inchPerInt = (double)inchesLowHigh / (double)(pumpOnAt - pumpOffAt);
  double inchOffset = (int)((double)offset * inchPerInt);
  int wLowInTmp = (inchOffset + (int)((double)pumpOffAt * inchPerInt));
  int wHighInTmp = (inchOffset + (int)((double)pumpOnAt * inchPerInt));
  int wCritInTmp = (int)mapp((double)SPN_WATER_CRITICAL, (double)SPN_WATER_LOW, (double)waterPercentHigh, (double)wLowInTmp, (double)wHighInTmp);
  sprintf(msg, "OK! Arm:save O: %d\"\n"
      "Low: %d\" %d%% (-%d%%)\n"
      "Hig: %d\" %d%% (+%d%%)\n"
      "Cri: %d\" %d%% (+%d%%)",
      (int) inchOffset,
       wLowInTmp, SPN_WATER_LOW, SPN_WATER_VARIANCE,
       wHighInTmp, waterPercentHigh, SPN_WATER_VARIANCE,
       wCritInTmp, SPN_WATER_CRITICAL, SPN_WATER_VARIANCE);
  display->displayMessage(msg);
  button = getPressedButton(armButton, disarmButton);
  if (button == disarmButton) {
    return;
  }
  finished = true;
  waterLow = (pumpOffAt);
  waterHigh = (pumpOnAt);
  waterLowIn = wLowInTmp;
  waterHighIn = wHighInTmp;

  display->displayMessage("Settings saved");
  reboot("");
}
void waitForButton(Button* b1) {
  getPressedButton(b1, nullptr);
}
bool isPressed(Button *b) {
  b->update();
  bool pressed = b->isPressed();
  while (b->isPressed()) {
    b->update();
    Particle.process();
  }
  return pressed;
}
Button* getPressedButton(Button* b1, Button*b2) {
  bool pressed = false;
  while (!pressed) {
    b1->update();
    b2->update();
    if (b1 != nullptr && b1->isPressed()) {
      while (b1->isPressed()){
        b1->update();
        Particle.process();
      }
      return b1;
    }
    if (b2 != nullptr && b2->isPressed()) {
      while (b2->isPressed()){
        b2->update();
        Particle.process();
      }
      return b2;
    }
    Particle.process();
  }
}
