Fenytestver/WIP/sumppitmodel/src/multipump.h

#ifdef DEBUG
//#include <iostream>
#endif // DEBUG

#ifndef MULTIPUMP_H
#define MULTIPUMP_H

#include "pump.h"
#include "state.h"
#define SPN_MULTIPUMP_MAX_PUMPS 2
#define SPN_MULTIPUMP_OFF 0
#define SPN_MULTIPUMP_ON 1
#define SPN_MULTIPUMP_TURBO 2

class MultiPump
{
  public:
    MultiPump();
    virtual ~MultiPump();
    virtual void addPump(Pump* pump);
    int update(State* state);
    void setup();
    int checkState();
    int getRpm(int index);
    int getPumpUptime(int index);
    bool isTurnedOn(int index);
  protected:

  private:
    int checkState(int index);

    Pump** pumps;
    short pumpCount;
};

#endif // MULTIPUMP_H
