Fenytestver/WIP/sumppitmodel/src/state.h

#ifndef STATE_H
#define STATE_H
struct State {
  long alarmReason;
  int mode;
  int pump1Rpm;
  int pump2Rpm;
  int pump1Alarm;
  int pump2Alarm;
  int pump1Uptime;
  int pump2Uptime;
  int levelIn;
  int levelPercent;
  int pump1On;
  int pump2On;
  bool leak;
  bool shutoffValve;
  bool floatSwitch;
  bool snoozed;
};
#endif
