Fenytestver/WIP/sumppitmodel/src/sumppitsensor.h

#ifdef DEBUG
//#include <iostream>
#endif // DEBUG

#ifndef SUMPPITSENSOR_H
#define SUMPPITSENSOR_H
#include "waterlevelsensor.h"
#include "multipump.h"
#include "leaksensor.h"
#include "spn_config.h"
#include "state.h"

using namespace spn;

class SumpPitSensor
{
  public:
    /** Default constructor */
    SumpPitSensor(WaterLevelSensor* _waterLevelSensors, int _numWaterSensors,
                  LeakSensor* _leakSensors, int _numLeakSensors,
                  MultiPump* _pump);
    /** Default destructor */
    virtual ~SumpPitSensor();

    /** Call at setup phase, once */
    virtual void setup();
    virtual bool isLeaking();
    virtual int checkState(State* outstate);
    virtual void updatePump(State* outstate);
    virtual int checkWaterLevelState(State* state);
  protected:
    /** Will return SPS_PUMP state bit-mask, where 0 is no error */
    virtual int checkPumpState();
    virtual int checkLeakState();

  protected:
    WaterLevelSensor* waterLevelSensors;
    short numWaterSensors;
    LeakSensor* leakSensors;
    int numLeakSensors;
    MultiPump* pump;
    int expectedPumpState;
  private:
    int lastWaterLevel;
};

#endif // SUMPPITSENSOR_H
