Fenytestver/WIP/sumppitmodel/src/button.h

#ifndef BUTTON_H
#define BUTTON_H
#include "onbuttonpresslistener.h"
#include "systemtime.h"

class Button
{
  public:
    /** Default constructor */
    Button(SystemTime* _systemTime, long _longPressTime);
    /** Default destructor */
    virtual ~Button();
    virtual void setup();
    void setOnButtonPressListener(OnButtonPressListener* _onPressListener) {
      onPressListener = _onPressListener;
    }

    void setOnButtonLongPressListener(OnButtonPressListener* _onLongPressListener) {
      onLongPressListener = _onLongPressListener;
    }

    virtual void press();
    virtual void update();
    virtual bool isPressed();
  protected:
    OnButtonPressListener* onPressListener;
    OnButtonPressListener* onLongPressListener;
    void setPressed(bool _pressed);
  private:
    long longPressTime;
    bool pressed;
    long pressedAt;
    bool longPressHandled;
    SystemTime* systemTime;
};

#endif // BUTTON_H
