Fenytestver/WIP/sumppitmodel/src/onbuttonpresslistener.cpp

#include "onbuttonpresslistener.h"

OnButtonPressListener::OnButtonPressListener()
{
  //ctor
}

OnButtonPressListener::~OnButtonPressListener()
{
  //dtor
}
void OnButtonPressListener::onPress()
{

}
