Fenytestver/WIP/sumppitmodel/src/sumppitinputs.cpp

#include "sumppitinputs.h"

SumpPitInputs::SumpPitInputs(Button* _disarmButton, Button* _maintenanceButton, Button* _armResetButton)
{
  //ctor
  disarmButton = _disarmButton;
  maintenanceButton = _maintenanceButton;
  armResetButton = _armResetButton;
}

SumpPitInputs::~SumpPitInputs()
{
  //dtor
}

void SumpPitInputs::setup() {
  disarmButton->setup();
  maintenanceButton->setup();
  armResetButton->setup();
}

void SumpPitInputs::update() {
  disarmButton->update();
  maintenanceButton->update();
  armResetButton->update();
}
