Fenytestver/WIP/(commit log)

2019-07-12 inital comit
    [DRILEGEND.CFG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]
2019-10-25 keepAlive 10 min; fix out_technical during maintenance
    [SumpPitActuatorProject.ino, SumpPitAlarmModuleProject.ino]
